EmbeddedSystemClass/H1AR1x-Hardware/README.md

# H1AR1x-Hardware
Hexabitz USB-B-to-UART Converter Module Hardware Design
