EmbeddedSystemClass/H1AR1x-Hardware/H1AR10/Released/BOM/H1AR1.xlsx

Qty | comment | designator | Description | MFN | MPN | OCTOPART_URL | TOLERANCE
1 | 100nF | C1 | CAP CER 10% X7R 0603 | AVX | 0603YC104K4T2A | https://octopart.com/c0603c104k8ractu-kemet-145075?r=sp&s=9bS9ASSwSEqMCE9KBEQZ0g | 10%
2 | 47pF | C13, C14 | CAP CER 10% X7R 0603 | 06035A470JAT2Aa | AVX | https://octopart.com/06035a470jat2a-avx-46507018# | 5%
1 | 100uF | C16 | 100µF ±20% 6.3V Ceramic Capacitor X5R 1210 (3225 Metric) | TDK | C3225X5R0J107M250AC | https://octopart.com/c3225x5r0j107m250ac-tdk-25947844 | 20%
2 | 1.00uF | C2, C17 | Cap Tant Solid SMD 2012 | AVX | TAJR105M016RNJ | https://octopart.com/tajr105m016rnj-avx-1188552 | 20%
3 | 4.7uF | C3, C4, C10 | Cap Tant Solid SMD 2012 | Panasonic | 10TPU4R7MSI | https://octopart.com/10tpu4r7msi-panasonic-29487748 | 20%
1 | 10nF | C5 | CAP CER 10% X7R 0603 | AVX | 0603YC103KAT4A | https://octopart.com/0603yc103kat4a-avx-2550362 | 10%
7 | 100nF | C6, C7, C8, C9, C11, C12, C15 | CAP CER 10% X7R 0603 | AVX | 0603YC104K4T2A | https://octopart.com/0603yc104k4t2a-avx-8120651# | 10%
2 | RED | D1 | Red 0603 130° Clear 54 mcd 2 V Surface Mount ChipLED ; | Vishay | VLMS1300-GS08 | https://octopart.com/vlms1300-gs08-vishay-21709201
 | YELLOW | D2 | Yellow 0603 130° Clear 54 mcd 2 V Surface Mount ChipLED ; | Vishay | VLMY1300-GS08 | https://octopart.com/vlmy1300-gs08-vishay-21709204?r=sp#
1 | Orange | D3 | Orange 0603 130° Clear 54 mcd 2 V Surface Mount ChipLED ; | Vishay | VLMO1300-GS08 | https://octopart.com/vlmo1300-gs08-vishay-21709200?r=sp
2 | FB-TDK_MMZ1608Y300B | FB1, FB2 | Ferrite Beads Multi-Layer 30Ohm 25% 100MHz 1.5A 50mOhm DCR 0603 | TDK | MMZ1608Y300B | https://octopart.com/mmz1608y300b-tdk-368280?r=sp&s=cd9_2ZEqQ9q9UNBuQgHAiA
1 | USB-B | PUSB* | BERG USB connector | ASSMANN WSW Components | A-USBSB | https://octopart.com/a-usbsb-assmann+wsw+components-192191#
1 | 3-644456-2 | PWR | Conn Unshrouded Header HDR 2 POS 2.54mm Solder ST Thru-Hole Bag/Box | TE Connectivity | 3-644456-2 | http://octopart.com/3-644456-2-te+connectivity+%2F+amp-39514699
1 | 270.0R | R1 | Thick Film Resistors - SMD 0603 | Panasonic | ERJ-3GEYJ271V | https://octopart.com/erj-3geyj271v-panasonic-55560546# | 5%
2 | 10.0K | R2, R9 | Thick Film Resistors - SMD 0603 | Vishay | CRCW060310K0JNEB | https://octopart.com/crcw060310k0jneb-vishay-46603269 | 5%
1 | 0.0R | R3 | Thick Film Resistors - SMD 0603 | Vishay | CRCW06030000Z0EAHP | https://octopart.com/crcw06030000z0eahp-vishay-44320230
2 | 27.0R | R4, R5 | Thick Film Resistors - SMD 0603 | Vishay | CRCW060327R0FKEA | https://octopart.com/crcw060327r0fkea-vishay-39833156 | 1%
1 | 270.0R | R6 | Thick Film Resistors - SMD 0603 | Panasonic | ERJ-3GEYJ271V | https://octopart.com/erj-3geyj271v-panasonic-55560546# | 5%
1 | 270.0R | R7 | Thick Film Resistors - SMD 0603 | Panasonic | ERJ-3GEYJ271V | https://octopart.com/erj-3geyj271v-panasonic-55560546# | 5%
1 | 4.7k | R8 | Thick Film Resistors - SMD 0603 | Vishay | CRCW06034K70FKEA | https://octopart.com/crcw06034k70fkea-vishay-39455708 | 1%
1 | STM32F091CBU6 | U1 | MCU 32-bit ARM Cortex M0 RISC 128KB Flash 2.5V/3.3V 48-Pin UFQFPN EP Frame | STMicroelectronics | STM32F091CBU6 | https://octopart.com/stm32f091cbu6-stmicroelectronics-51988677?r=sp&s=bU6fpgsrTZOxHyt7jkfh3w
1 | FT230XQ-R | U2 | USB to BASIC UART | FTDI, | FT230XQ-R | https://octopart.com/ft230xq-r-ftdi-22061504?r=sp
1 | LM3940IMP-3.3 | U3 | Low Dropout Regulator | Texas Instruments | LM3940IMP-3.3/NOPB | https://octopart.com/lm3940imp-3.3%2Fnopb-texas+instruments-24823014?r=sp
1 | XTALL_CSTCE8M00G52 | X1 | MURATA CSTCE8M00G52-R0 RESONATOR, SMD, 8MHZ ; | Murata | CSTCE8M00G52Z-R0 | https://octopart.com/cstce8m00g52z-r0-murata-17755941?r=sp&s=JDnNJnrHQhyS8Zk4ofFWXw
