EmbeddedSystemClass/H1AR1x-Hardware/H1AR10/Documentation/H1AR10 Schematics.pdf

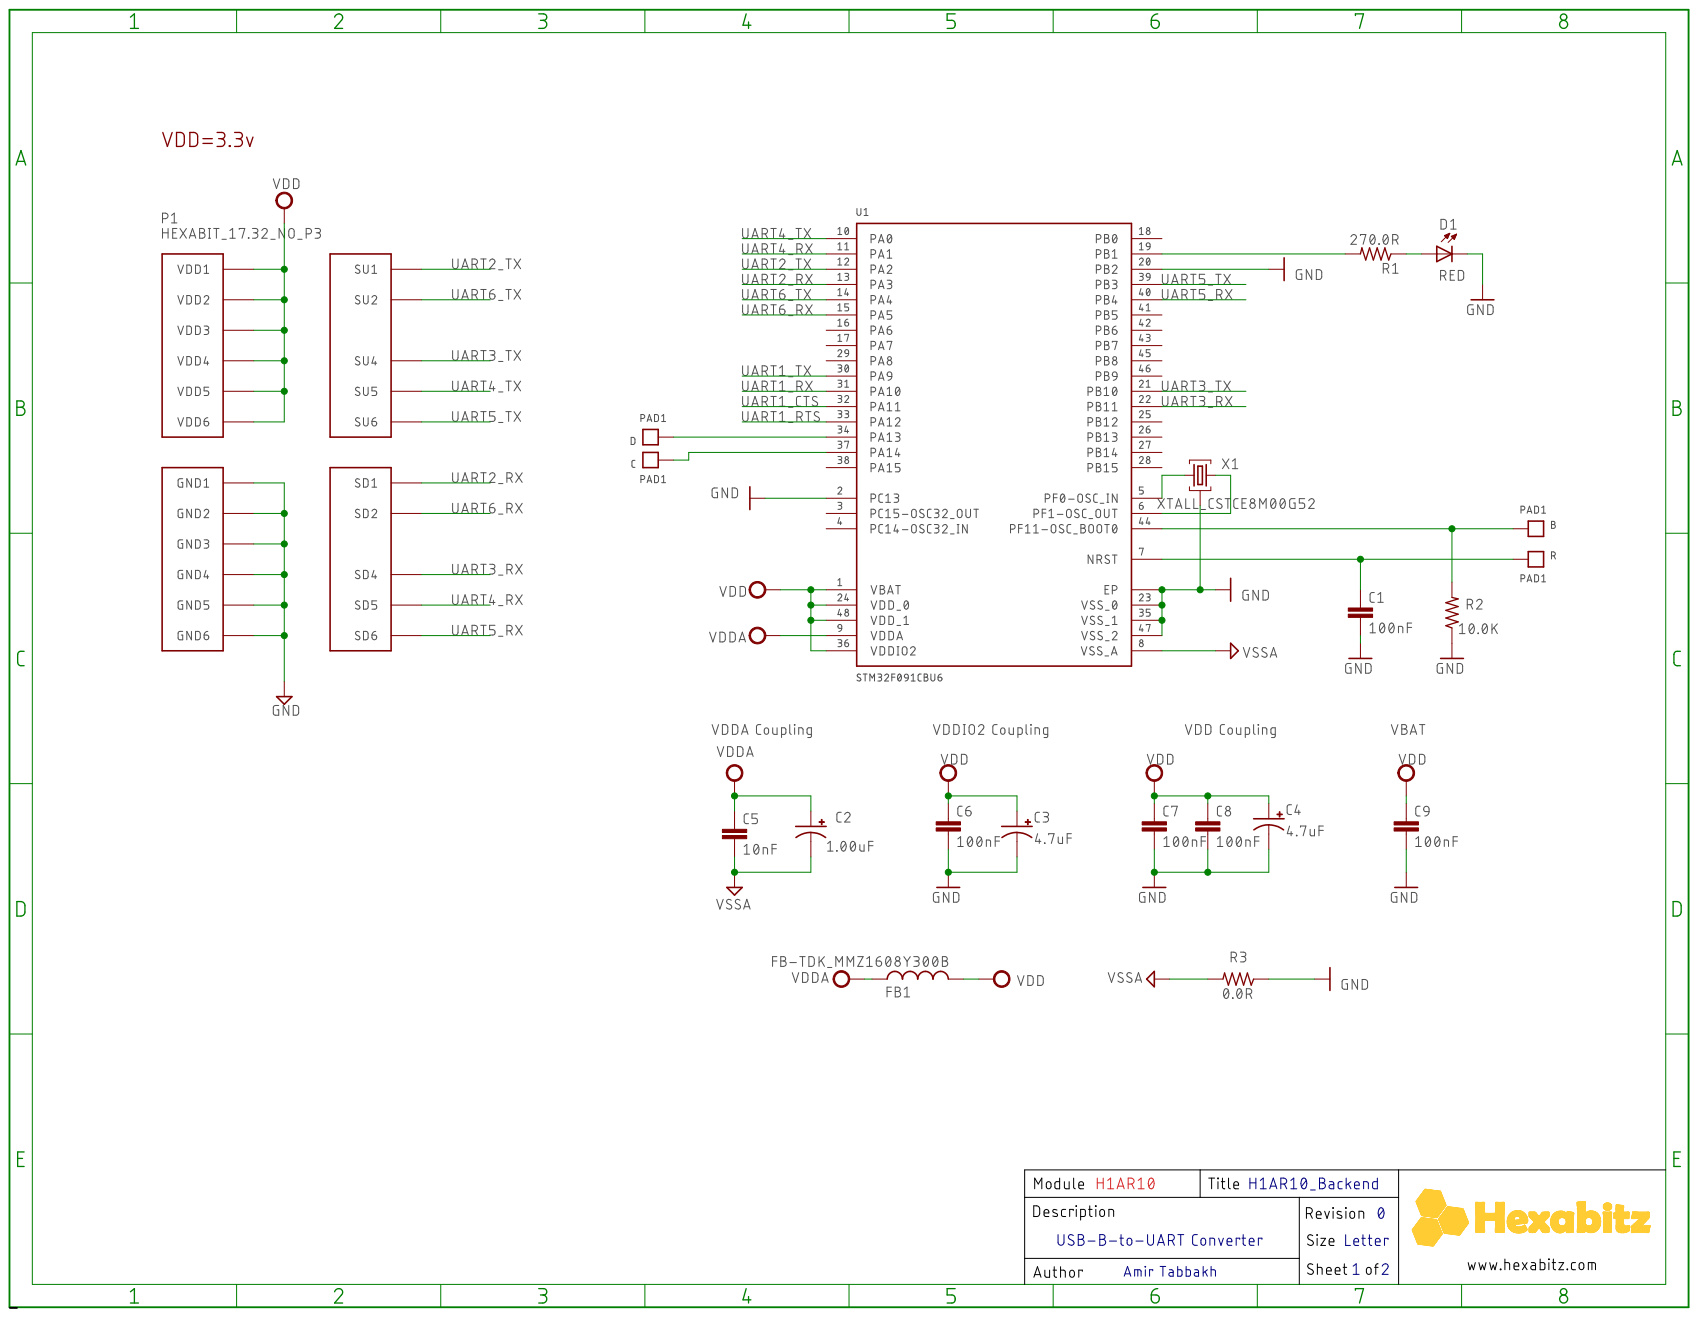
[picture p1: page 1]

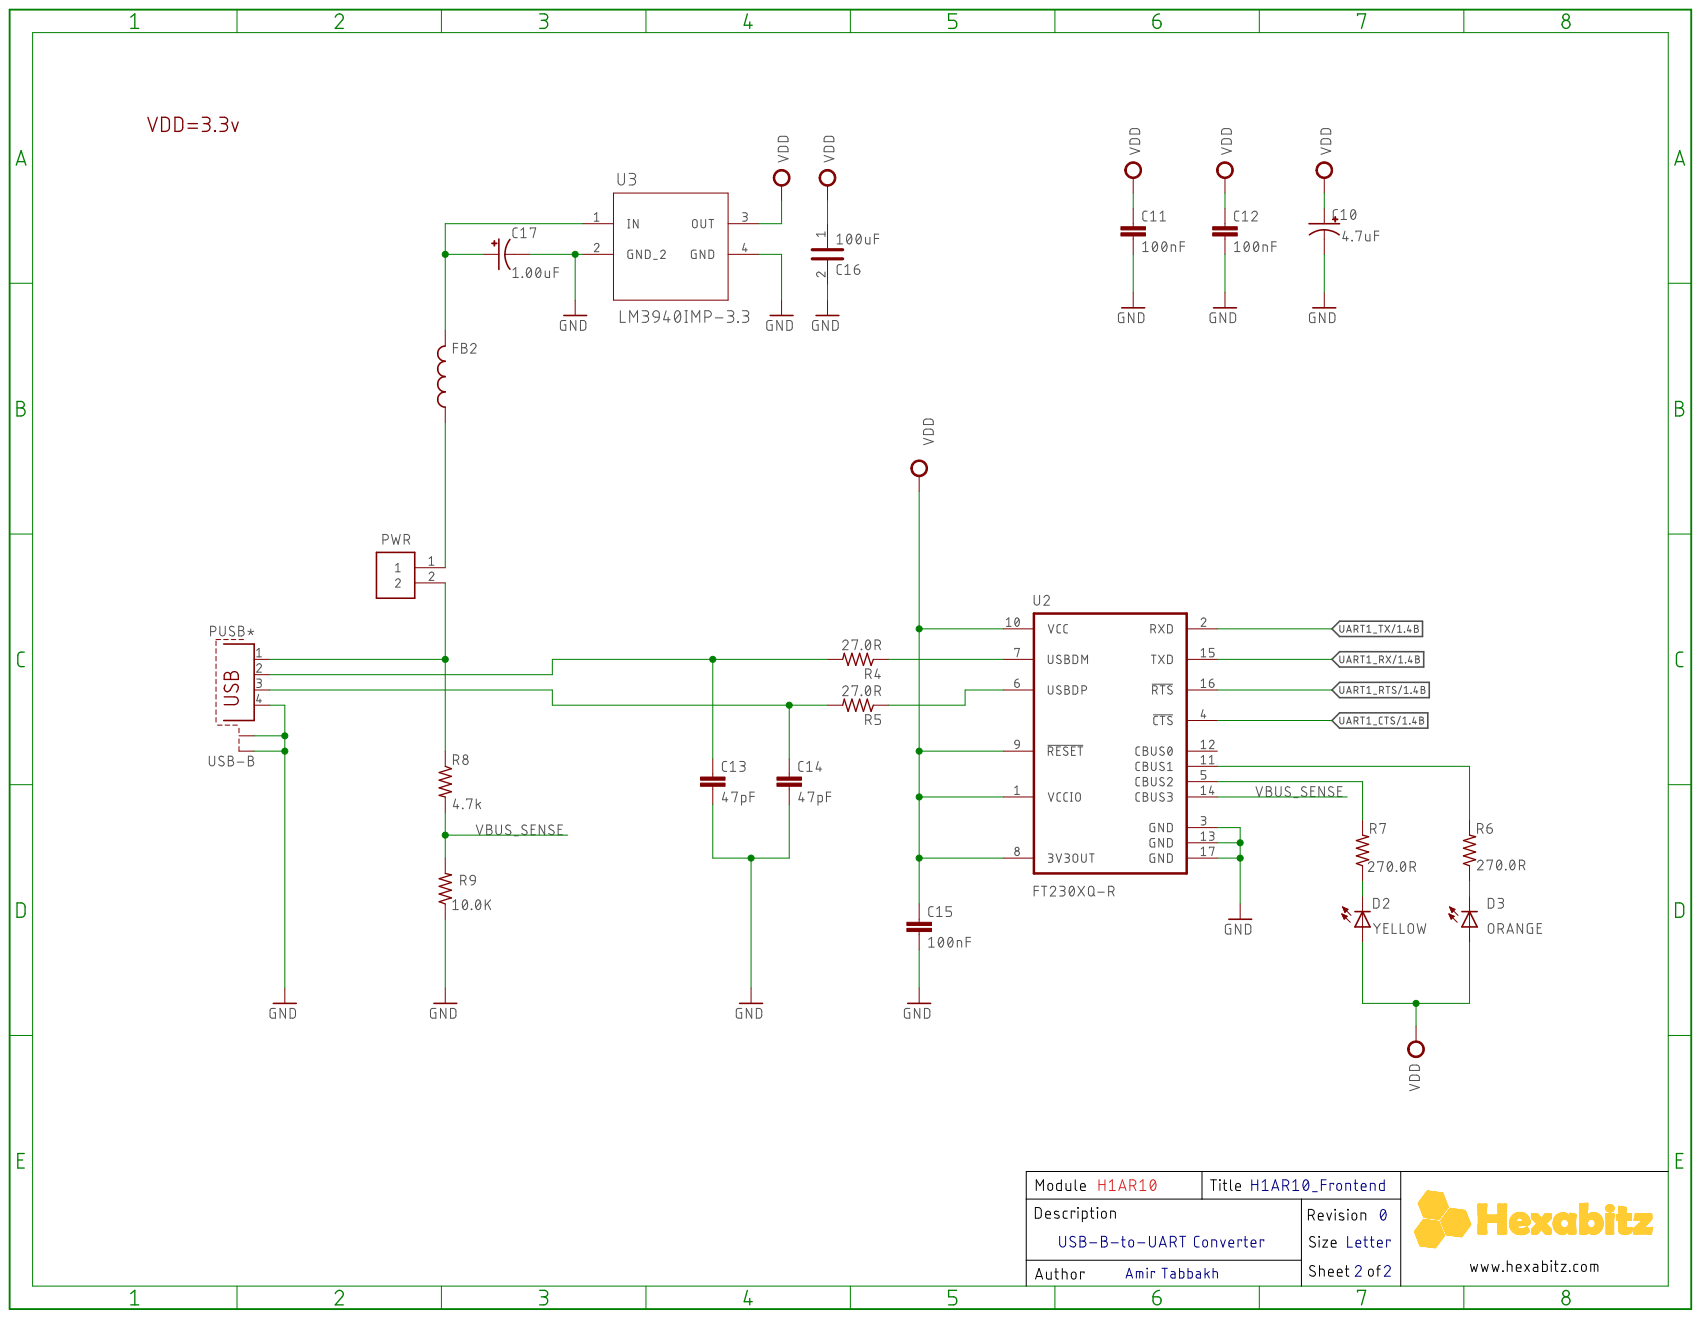
[picture p2: page 2]
