EmbeddedSystemClass/H1AR1x-Hardware/H1AR10/Design/H1AR10.brd

## EAGLE design H1AR10/Design/H1AR10.brd (2020-03-25)

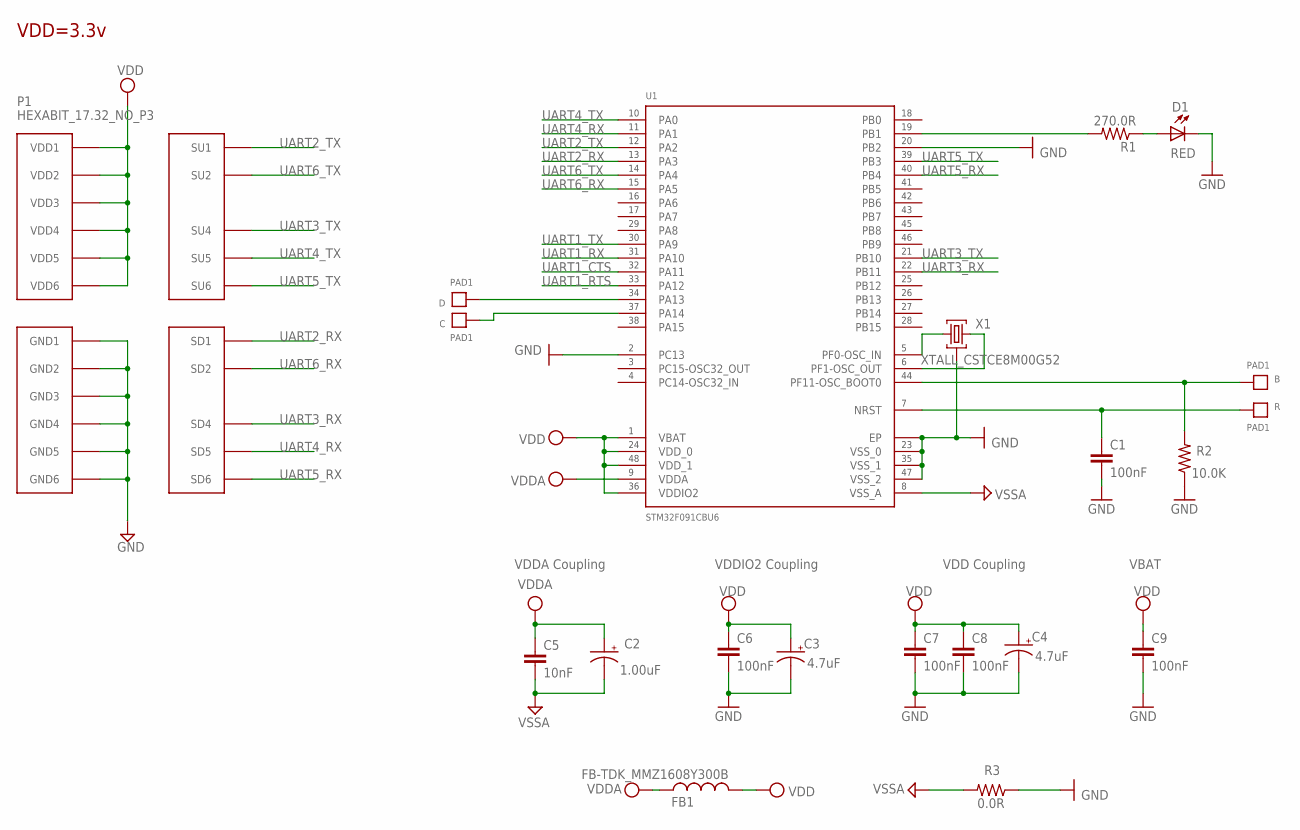
[picture p3: schematic H1AR10.sch, sheet 1]

Parts:
B: PAD1
C: PAD1
C1, C6, C7, C8, C9: 100nF; C-0603; TOLERANCE 10%; VOLTAGE_RATING 16V; MPN 0603YC104K4T2A
C2: 1.00uF; C-0805-POL; TOLERANCE 20%; VOLTAGE_RATING 16V; MPN TAJR105M016RNJ
C3, C4: 4.7uF; C-0805-POL; TOLERANCE 20%; VOLTAGE_RATING 10V; MPN 10TPU4R7MSI
C5: 10nF; C-0603; TOLERANCE 10%; VOLTAGE_RATING 16V; MPN 0603YC103KAT4A
D: PAD1
D1: RED; VLMS1300-GS08; MPN VLMS1300-GS08
FB1: FB-TDK_MMZ1608Y300B; MPN MMZ1608Y300B
P1: HEXABIT_17.32_NO_P3
R: PAD1
R1: 270.0R; R-0603; TOLERANCE 5%; MPN ERJ-3GEYJ271V
R2: 10.0K; R-0603; TOLERANCE 5%; MPN CRCW060310K0JNEB
R3: 0.0R; R-0603; MPN CRCW06030000Z0EAHP
U1: STM32F091CBU6
X1: XTALL_CSTCE8M00G52

Connections:
B1: B.P$1, B.P$2, R2.2, U1.P$44 (PF11-OSC_BOOT0)
GND: C1.2, C3.2 (-), C4.2 (-), C6.2, C7.2, C8.2, C9.2, D1.C, P1.PAD_PD7 (GND1), P1.PAD_PD8 (GND2), P1.PAD_PD9 (GND3), P1.PAD_PD10 (GND4), P1.PAD_PD11 (GND5), P1.PAD_PD12 (GND6), R2.1, R3.1, U1.EP, U1.P$2 (PC13), U1.P$20 (PB2), U1.P$23 (VSS_0), U1.P$35 (VSS_1), U1.P$47 (VSS_2), X1.P$2 (2); also elsewhere on the board
unnamed: U1.P$5 (PF0-OSC_IN), X1.P$1 (1)
unnamed: U1.P$6 (PF1-OSC_OUT), X1.P$3 (3)
unnamed: D.P$1, D.P$2, U1.P$34 (PA13)
unnamed: C.P$1, C.P$2, U1.P$37 (PA14)
unnamed: D1.A, R1.1
unnamed: R1.2, U1.P$19 (PB1)
R1: C1.1, R.P$1, R.P$2, U1.P$7 (NRST)
UART1_CTS: U1.P$32 (PA11); also elsewhere on the board
UART1_RTS: U1.P$33 (PA12); also elsewhere on the board
UART1_RX: U1.P$31 (PA10); also elsewhere on the board
UART1_TX: U1.P$30 (PA9); also elsewhere on the board
UART2_RX: P1.PAD_PD1 (SD1), U1.P$13 (PA3)
UART2_TX: P1.PAD_PU1 (SU1), U1.P$12 (PA2)
UART3_RX: P1.PAD_PD4 (SD4), U1.P$22 (PB11)
UART3_TX: P1.PAD_PU4 (SU4), U1.P$21 (PB10)
UART4_RX: P1.PAD_PD5 (SD5), U1.P$11 (PA1)
UART4_TX: P1.PAD_PU5 (SU5), U1.P$10 (PA0)
UART5_RX: P1.PAD_PD6 (SD6), U1.P$40 (PB4)
UART5_TX: P1.PAD_PU6 (SU6), U1.P$39 (PB3)
UART6_RX: P1.PAD_PD2 (SD2), U1.P$15 (PA5)
UART6_TX: P1.PAD_PU2 (SU2), U1.P$14 (PA4)
VDD: C3.1 (+), C4.1 (+), C6.1, C7.1, C8.1, C9.1, FB1.2, P1.PAD_PU7 (VDD1), P1.PAD_PU8 (VDD2), P1.PAD_PU9 (VDD3), P1.PAD_PU10 (VDD4), P1.PAD_PU11 (VDD5), P1.PAD_PU12 (VDD6), U1.P$1 (VBAT), U1.P$24 (VDD_0), U1.P$36 (VDDIO2), U1.P$48 (VDD_1); also elsewhere on the board
VDDA: C2.1 (+), C5.1, FB1.1, U1.P$9 (VDDA)
VSSA: C2.2 (-), C5.2, R3.2, U1.P$8 (VSS_A)

Notes on the sheet:
VDDA Coupling
VDDIO2 Coupling
VDD Coupling
VBAT
VDD=3.3v

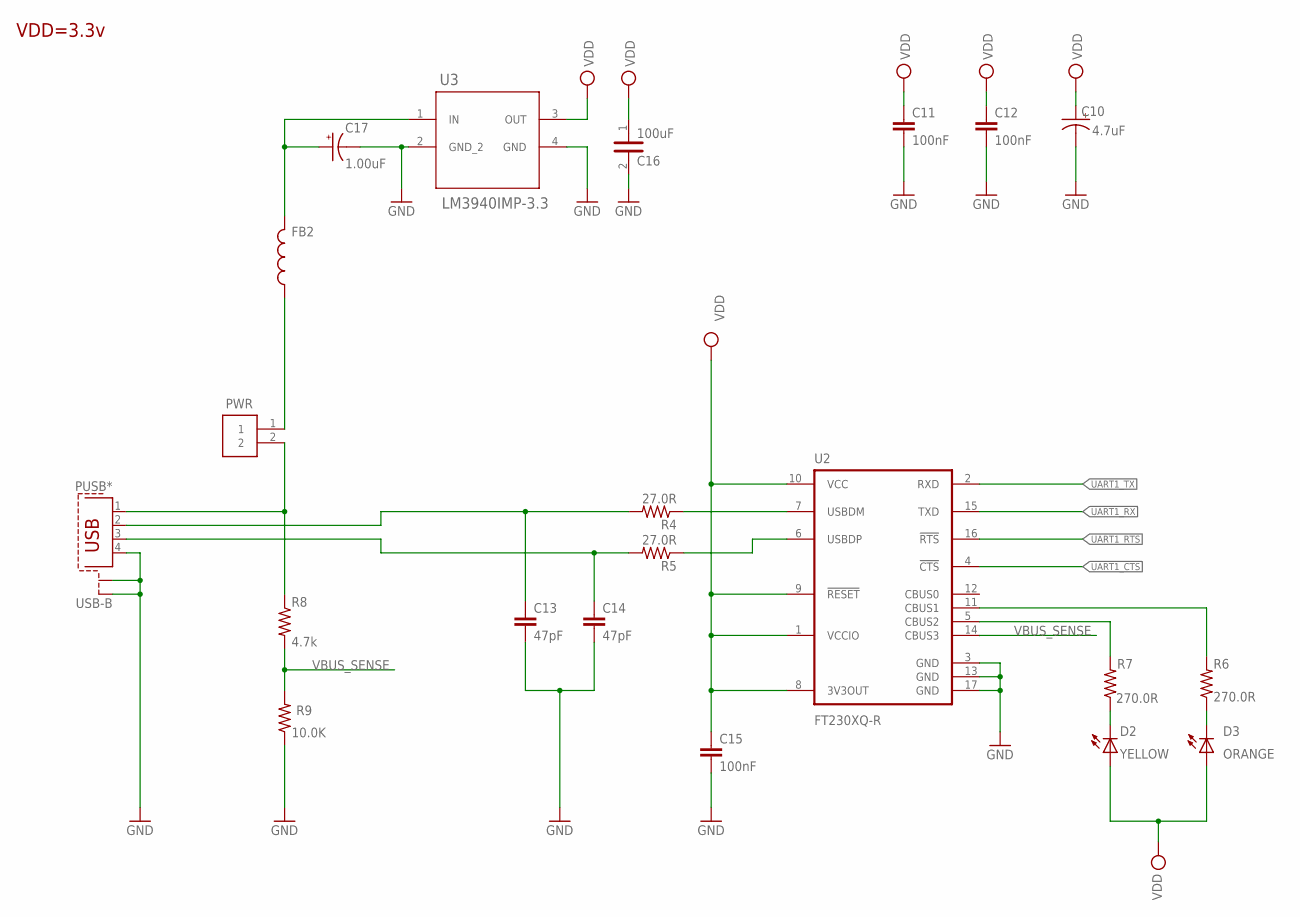
[picture p4: schematic H1AR10.sch, sheet 2]

Parts:
C10: 4.7uF; C-0805-POL; TOLERANCE 20%; VOLTAGE_RATING 10V; MPN 10TPU4R7MSI
C11, C12, C15: 100nF; C-0603; TOLERANCE 10%; VOLTAGE_RATING 16V; MPN 0603YC104K4T2A
C13, C14: 47pF; C-0603; TOLERANCE 5%; VOLTAGE_RATING 50; MPN AVX
C16: 100uF; C-3225; TOLERANCE 20%; VOLTAGE 6.3V; MPN C3225X5R0J107M250AC
C17: 1.00uF; C-0805-POL; TOLERANCE 20%; VOLTAGE_RATING 16V; MPN TAJR105M016RNJ
D2: YELLOW; VLMS1300-GS08; MPN VLMY1300-GS08
D3: ORANGE; VLMS1300-GS08; MPN VLMO1300-GS08
FB2: FB-TDK_MMZ1608Y300B; MPN MMZ1608Y300B
PUSB*: USB-B; PN61729-S
PWR: 3-644456-2; TE_3-644456-2
R4, R5: 27.0R; R-0603; TOLERANCE 1%; MPN CRCW060327R0FKEA
R6, R7: 270.0R; R-0603; TOLERANCE 5%; MPN ERJ-3GEYJ271V
R8: 4.7k; R-0603; TOLERANCE 1%; MPN CRCW06034K70FKEA
R9: 10.0K; R-0603; TOLERANCE 5%; MPN CRCW060310K0JNEB
U2: FT230XQ-R; QFN16
U3: LM3940IMP-3.3; SOT230P696X180-4N

Connections:
GND: C10.2 (-), C11.2, C12.2, C13.2, C14.2, C15.2, C16.2, C17.2 (-), PUSB*.4, PUSB*.S1, PUSB*.S2, R9.1, U2.3 (GND), U2.13 (GND), U2.17 (GND), U3.2 (GND_2), U3.4 (GND); also elsewhere on the board
unnamed: D3.C, R6.1
unnamed: R7.2, U2.5 (CBUS2)
unnamed: D2.C, R7.1
unnamed: R6.2, U2.11 (CBUS1)
unnamed: R4.1, U2.7 (USBDM)
unnamed: R5.1, U2.6 (USBDP)
unnamed: C14.1, PUSB*.3, R5.2
unnamed: C13.1, PUSB*.2, R4.2
unnamed: FB2.1, PWR.1
unnamed: C17.1 (+), FB2.2, U3.1 (IN)
unnamed: PUSB*.1, PWR.2, R8.1
UART1_CTS: U2.4 (!CTS!); also elsewhere on the board
UART1_RTS: U2.16 (!RTS!); also elsewhere on the board
UART1_RX: U2.15 (TXD); also elsewhere on the board
UART1_TX: U2.2 (RXD); also elsewhere on the board
VBUS_SENSE: R8.2, R9.2, U2.14 (CBUS3)
VDD: C10.1 (+), C11.1, C12.1, C15.1, C16.1, D2.A, D3.A, U2.1 (VCCIO), U2.8 (3V3OUT), U2.9 (!RESET!), U2.10 (VCC), U3.3 (OUT); also elsewhere on the board

Notes on the sheet:
VDD=3.3v

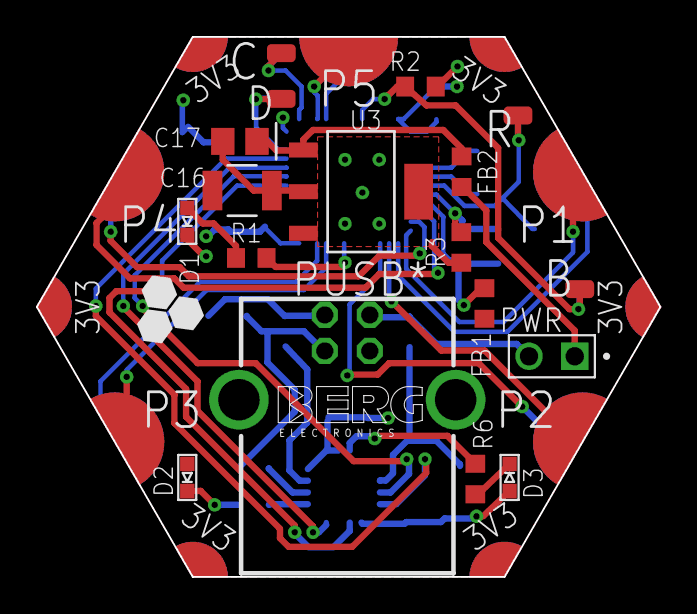
[picture p5: board H1AR10.brd from above]

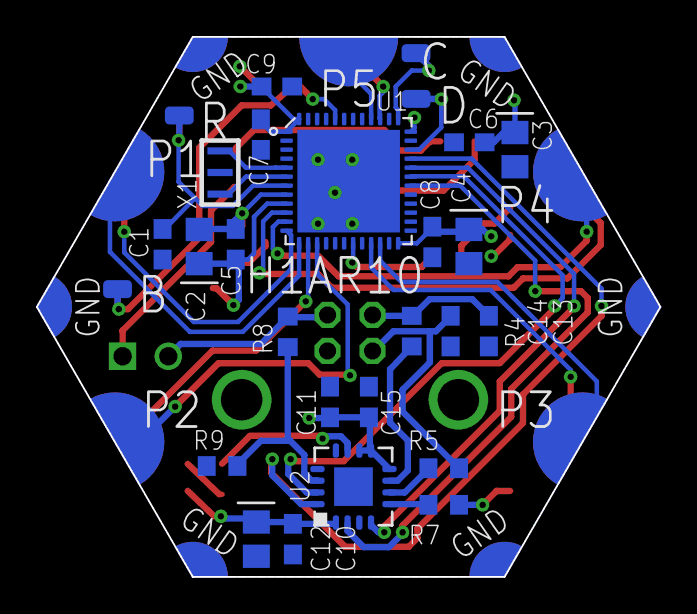
[picture p6: board H1AR10.brd from below]

Board: 2 copper layers, 34.6 x 30.0 mm, 42 parts (24 on the bottom side), 38 nets.
