EmbeddedSystemClass/H1AR1x-Hardware/(commit log)

2020-03-01 Add template files
    [H1AR10.brd, H1AR10.sch]
2020-03-15 final un-checked
    [H1AR10.brd, H1AR10.sch]
2020-03-17 rotate "C" & "D" pads 90 degrees chage X2 (label) to PUSB* change the led pin to (PB1) pin make "R" pad away enough form "B" pad fix some clearnce issues
    [H1AR10.brd, H1AR10.sch]
2020-03-24 USB_B hardware
    [copper_bottom.gbr, copper_top.gbr, gerber_job.gbrjob, profile.gbr, silkscreen_bottom.gbr, silkscreen_top.gbr, soldermask_bottom.gbr, soldermask_top.gbr]
